HexabitzPlatform/H08R7x/README.md

# H08R7x-Hardware
Hexabitz VL53L1 Time-of-Flight IR Sensor Module Hardware Design
