HexabitzPlatform/H08R7x/Documentation/H08R7 Schematic.pdf

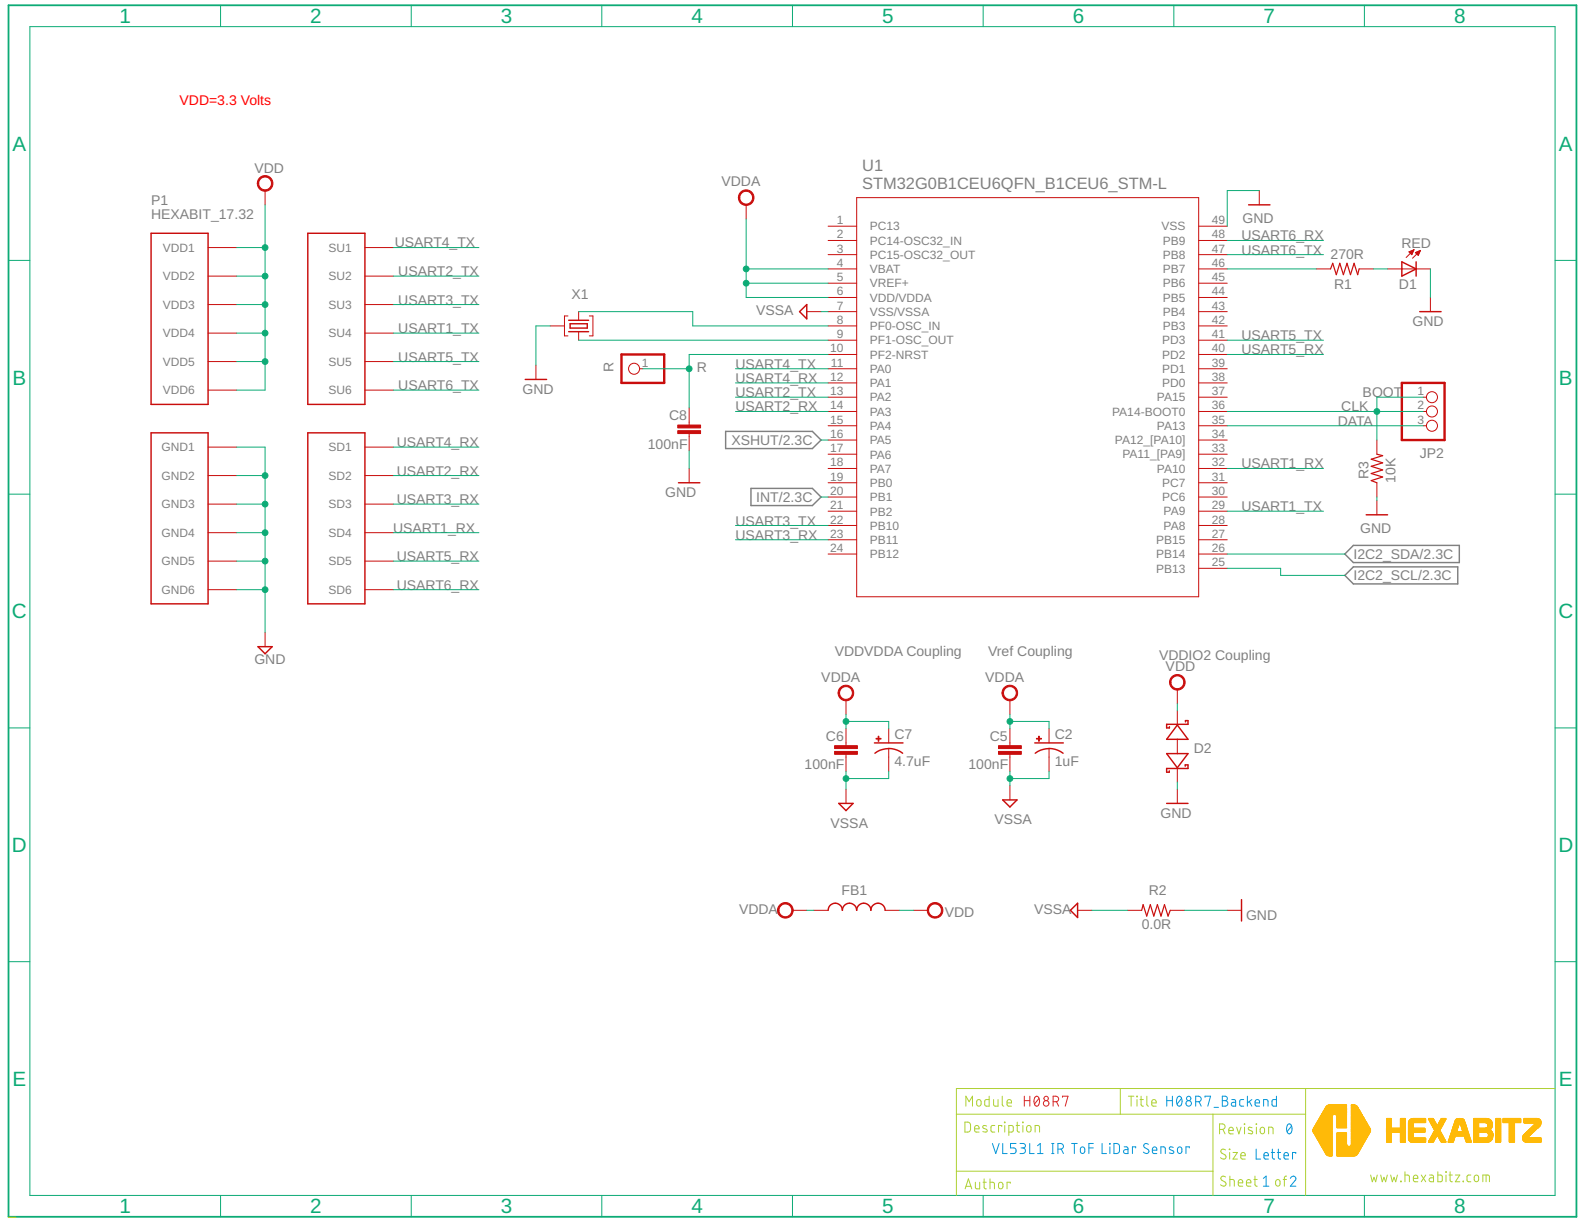
[picture p1: page 1]

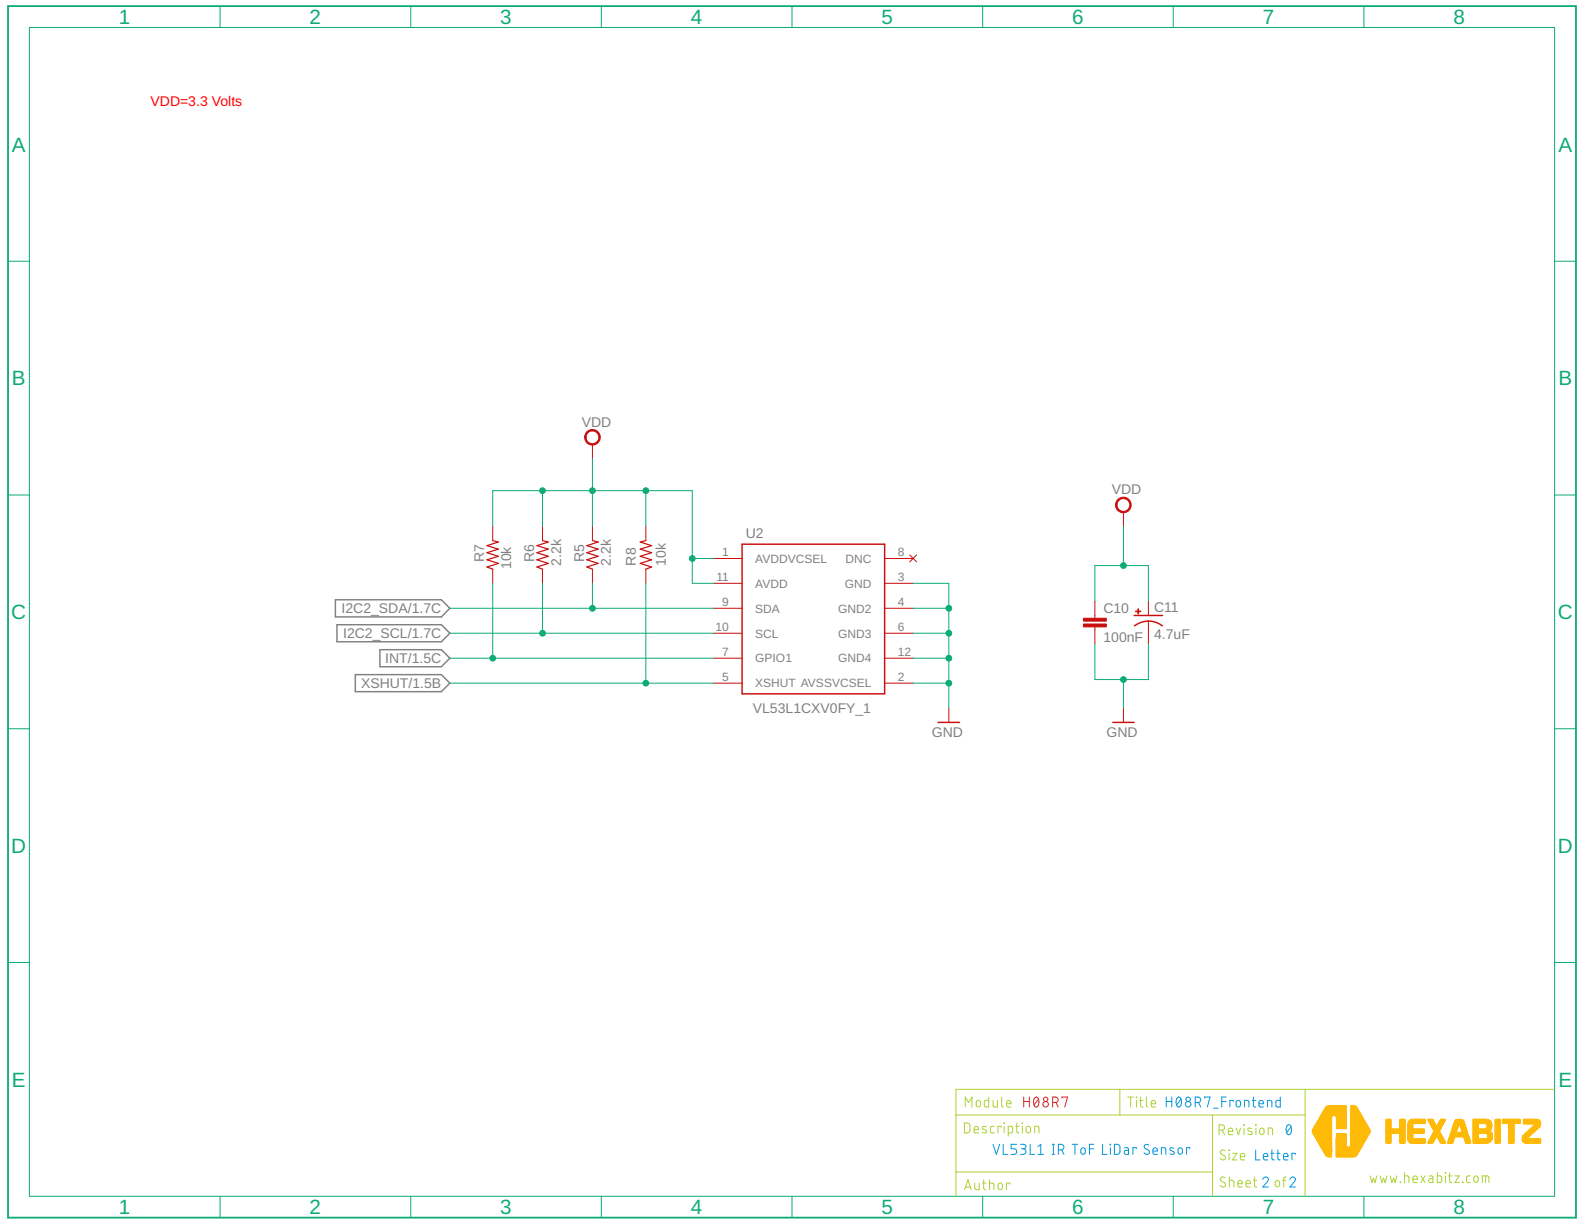
[picture p2: page 2]
