HexabitzPlatform/H08R7x/(commit log)

2024-03-24 All Finish, Reviewed Version
    [H08R7.brd, H08R7.sch, H08R7.xlsx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]
2024-04-01 -Update the logo
    [drill_1_16.xln, gerber_job.gbrjob, silkscreen_top.gbr]
2024-07-14 -Add TVS diode -Change the MCU to STM32G0B1CEU6 -Activate the thermal option for the polygon - fix the bom
    [H08R7.brd, H08R7.sch, H08R7.xlsx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]
